HanifJauharIslami/EcoBin/Progress Report Per Minggu/Laporan Minggu Ke-11.pdf

# EcoBin

### Inovasi Tempat Sampah Pintar Berbasis IoT untuk Pemilahan Sampah Otomatis dan Ramah Lingkungan


Nama Anggota Team:

1. Regar Mukti Wijaya / 2122600032 | (Hardware Developer)
2. Yunanta Adi Wijaya / 2122600035 | (Data Analyst)
3. Veda Alfa Elydal / 2122600039 | (Software Developer)
4. Dwi Angga Ramadhani / 2122600053 | (UI/UX Designer)
5. Hanif Jauhar Islami / 2122600048 | (Project Manager)
6. Dewa Gede Angkasa Arinanta / 2122600059 | (3D Designer)

Progress Laporan Mingguan

Laporan Minggu Ke-11

- Pembuatan video demonstrasi rangkaian pada aplikasi Wokwi di Youtube

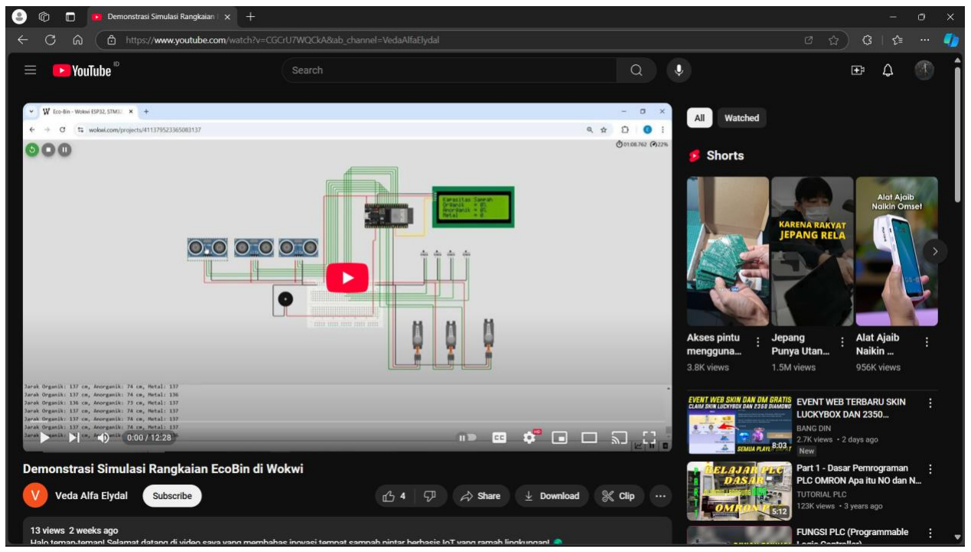
[picture p19: figure]

- Pembelian komponen untuk pembuatan hardware
List komponen yang diperlukan untuk pembuatan projek ini telah dilampirkan pada tampilan README.md dengan detail sebagai berikut:
1. Hardware
a. ESP32
b. Sensor Ultrasonik
c. Sensor Proximity Induktif
d. Sensor Proximity Kapasitif
e. Sensor Proximity Infrared
f. Motor Servo
g. LCD 20X4 I2C
h. Modul Df Player
i. Speaker
j. Power Supply
2. Software
a. Arduino ide
b. KiCad
c. Inventor
d. Visual Studio Code (VSC)
e. Eagle
3. Alat
a. Solder
b. Timah solder

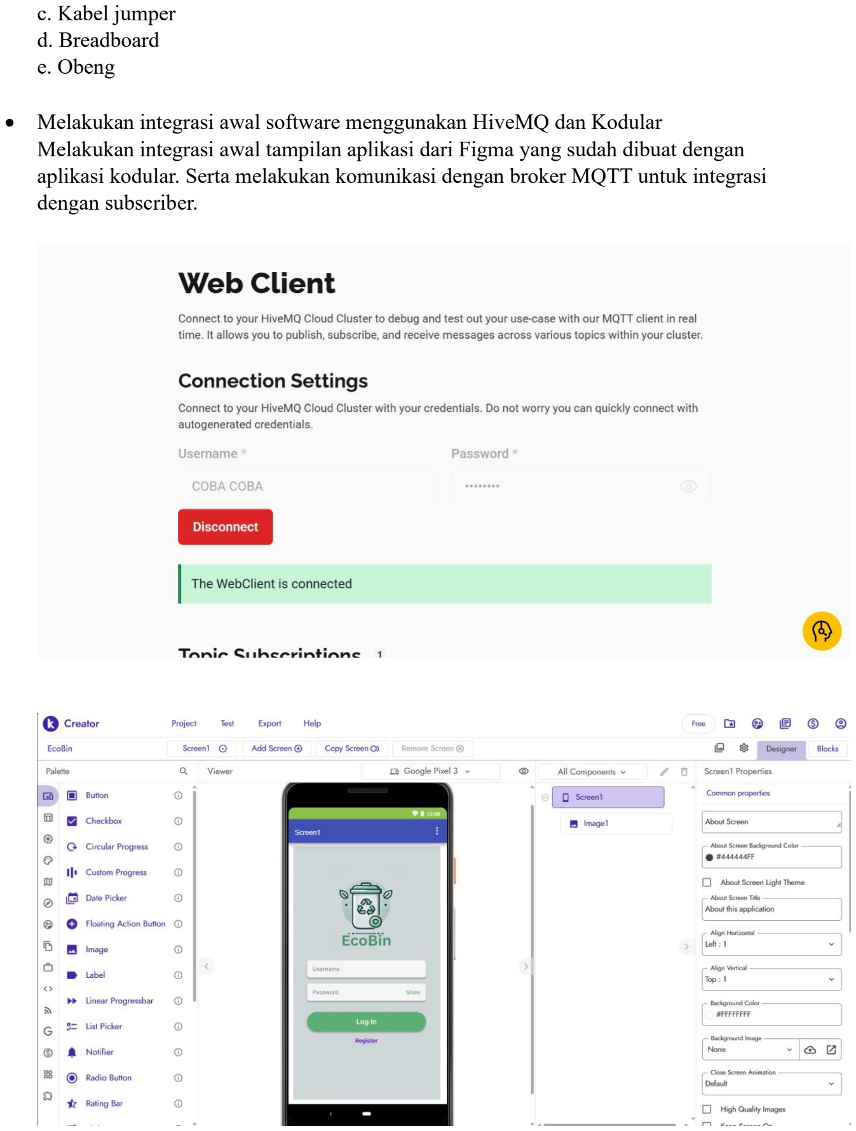
[picture p20: page 3]

c. Kabel jumper
d. Breadboard
e. Obeng
- Melakukan integrasi awal software menggunakan HiveMQ dan Kodular Melakukan integrasi awal tampilan aplikasi dari Figma yang sudah dibuat dengan aplikasi kodular. Serta melakukan komunikasi dengan broker MQTT untuk integrasi dengan subscriber.
