HanifJauharIslami/EcoBin/Progress Report Per Minggu/Laporan Minggu Ke-10.pdf

# EcoBin

### Inovasi Tempat Sampah Pintar Berbasis IoT untuk Pemilahan Sampah Otomatis dan Ramah Lingkungan


Nama Anggota Team:

1. Regar Mukti Wijaya / 2122600032 | (Hardware Developer)
2. Yunanta Adi Wijaya / 2122600035 | (Data Analyst)
3. Veda Alfa Elydal / 2122600039 | (Software Developer)
4. Dwi Angga Ramadhani / 2122600053 | (UI/UX Designer)
5. Hanif Jauhar Islami / 2122600048 | (Project Manager)
6. Dewa Gede Angkasa Arinanta / 2122600059 | (3D Designer)

Progress Laporan Mingguan

Laporan Minggu Ke-10

- Pembuatan Blok Diagram Sistem EcoBin

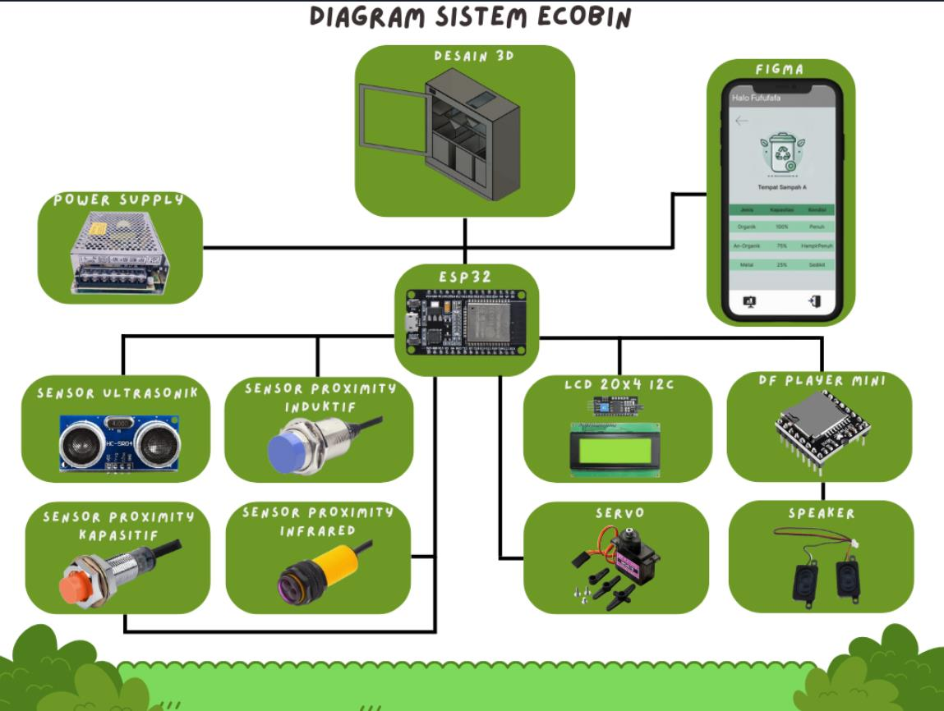
[picture p21: figure]

- Finishing Desain Skematik PCB EcoBin
Penyelesaian tahap desain skematik PCB menggunakan software KiCad, dan juga pencetakan PCB dengan detail desain skematik sebagai berikut:

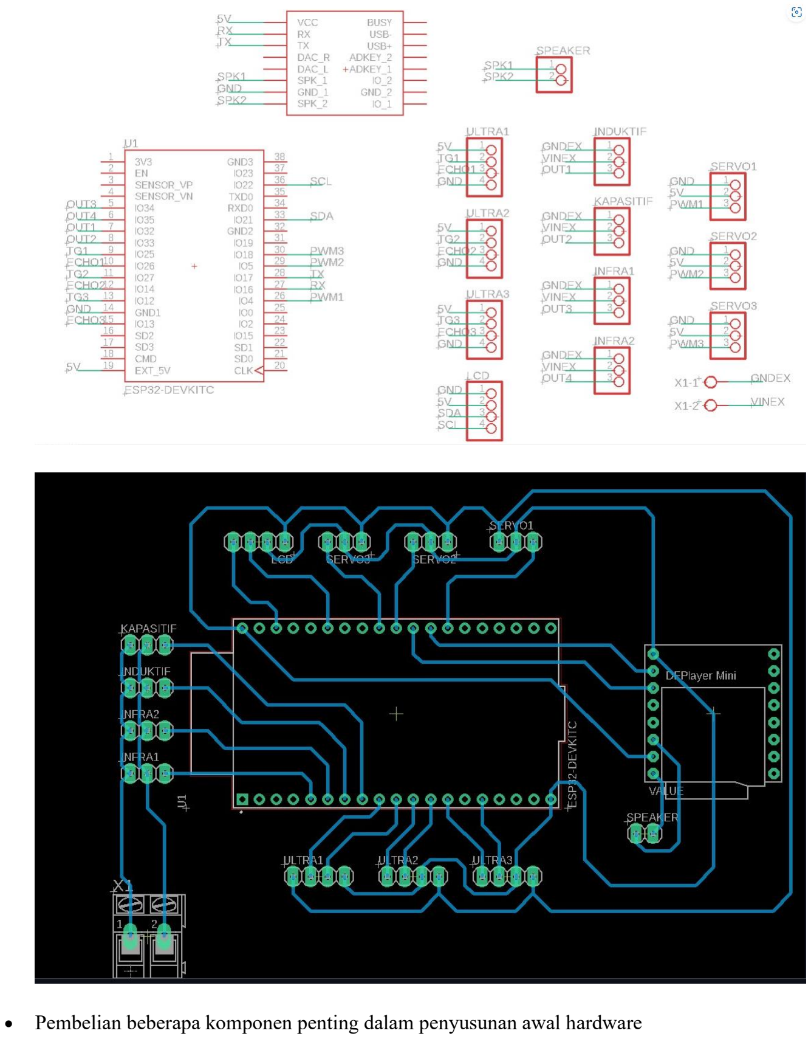
[picture p22: page 3]

- Pembelian beberapa komponen penting dalam penyusunan awal hardware

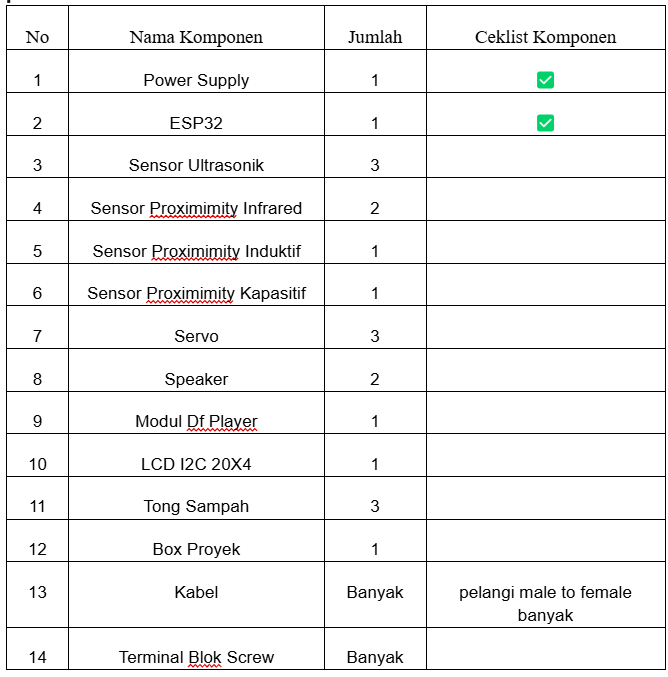
[picture p23: figure]
