HanifJauharIslami/EcoBin/Progress Report Per Minggu/Laporan Minggu Ke-14.pdf

# EcoBin

### Inovasi Tempat Sampah Pintar Berbasis IoT untuk Pemilahan Sampah Otomatis dan Ramah Lingkungan


Nama Anggota Team:

1. Regar Mukti Wijaya / 2122600032 | (Hardware Developer)
2. Yunanta Adi Wijaya / 2122600035 | (Data Analyst)
3. Veda Alfa Elydal / 2122600039 | (Software Developer)
4. Dwi Angga Ramadhani / 2122600053 | (UI/UX Designer)
5. Hanif Jauhar Islami / 2122600048 | (Project Manager)
6. Dewa Gede Angkasa Arinanta / 2122600059 | (3D Designer)

Progress Laporan Mingguan

Laporan Minggu Ke-14

- Finalisasi Alat
Setelah pengecekan dari semua komponen bekerja dengan normal, maka EcoBin dapat digunakan dengan hasil dari video simulasi, video promosi, animasi 3D, hingga video presentasi yang detailnya dapat dilihat pada github bagian Readme.

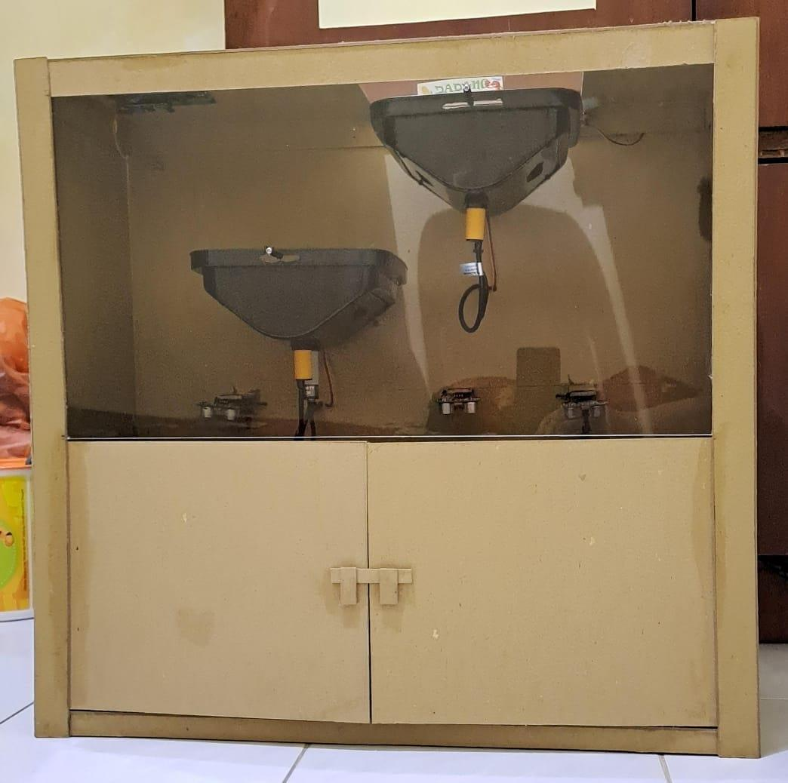
[picture p31: figure]

EcoBin yang sudah siap digunakan

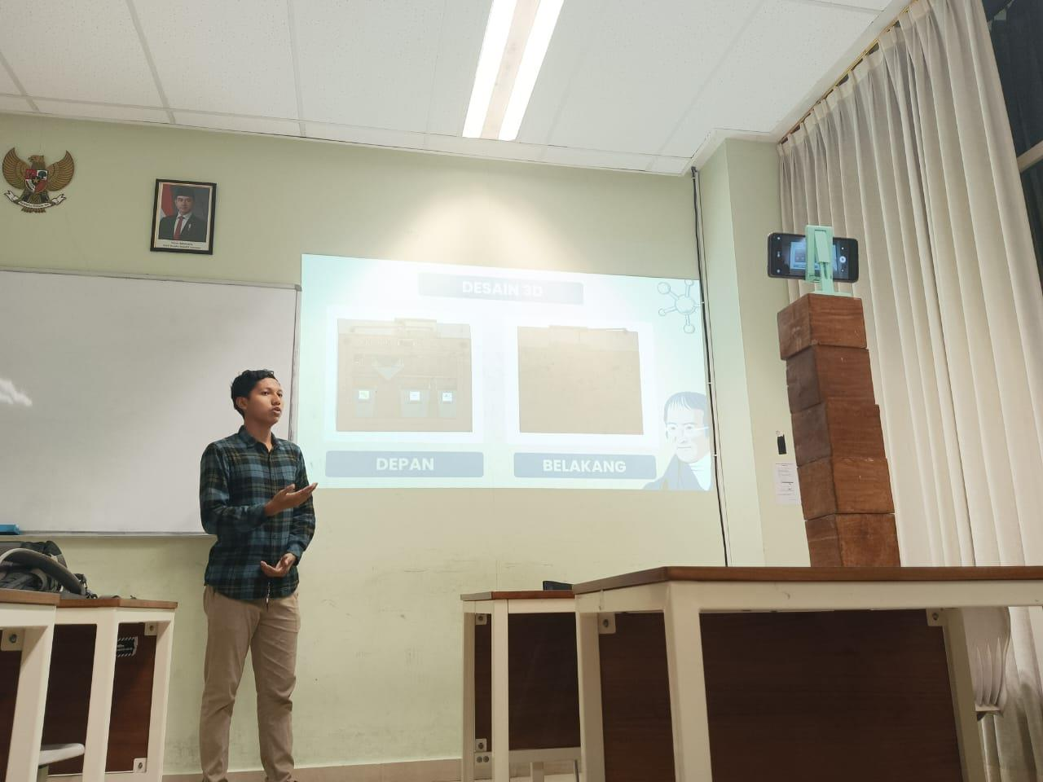
[picture p32: figure]

Presentasi Final Project EcoBin
