HanifJauharIslami/EcoBin/Dokumentasi/Flyer_EcoBin.pdf

# Inovasi Tempat Sampah Pintar Berbasis IoT untuk Pemilihan Sampah Otomatis dan Ramah Lingkungan

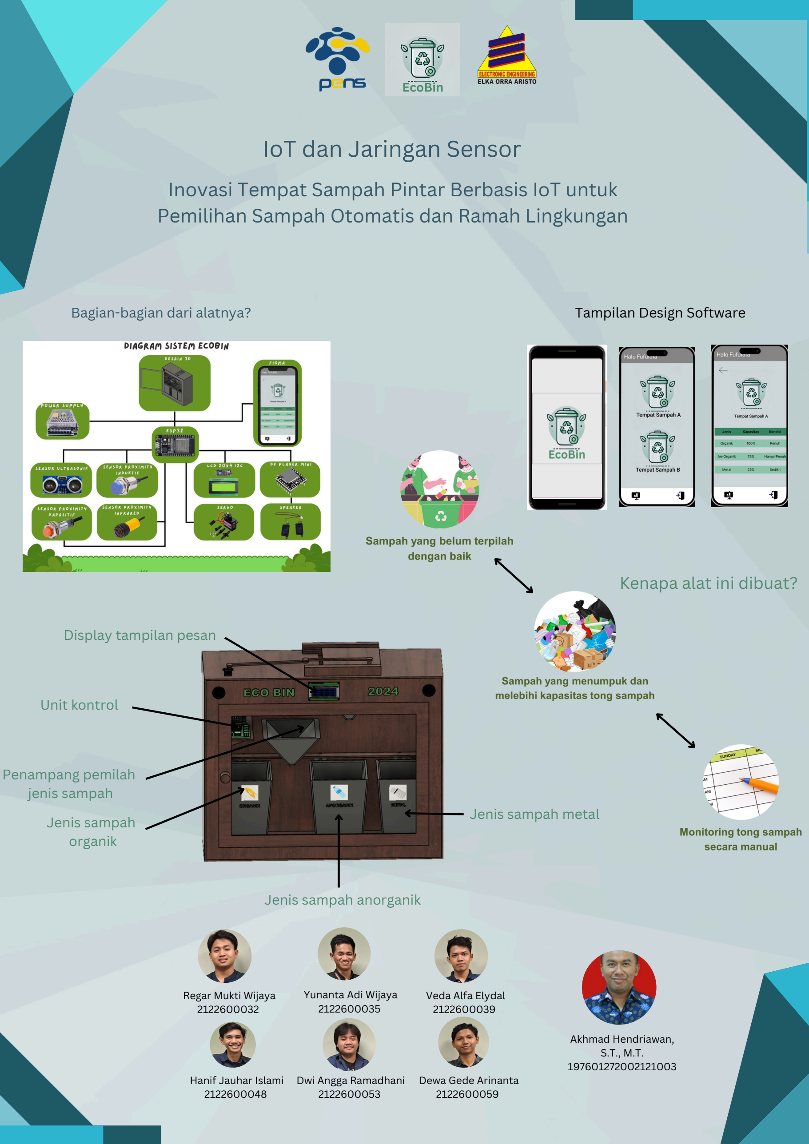
[picture p35: page 1]

## Display tampilan pesan

## Unit kontrol

## Penampang pemilah jenis sampah

## Jenis sampah organik

## Jenis sampah anorganik

## Jenis sampah metal

## Kenapa alat ini dibuat?

## Bagian-bagian dari alatnya?

Regar Mukti Wijaya
2122600032

Yunanta Adi Wijaya
2122600035

Veda Alfa Elydal
2122600039

Hanif Jauhar Islami
2122600048

Dwi Angga Ramadhani
2122600053

Dewa Gede Arinanta
2122600059

Akhmad Hendriawan,
S.T., M.T.
197601272002121003

## Tampilan Design Software

# IoT dan Jaringan Sensor
