HanifJauharIslami/EcoBin/Desain & Perencanaan/Mind Map Ide Project.pdf

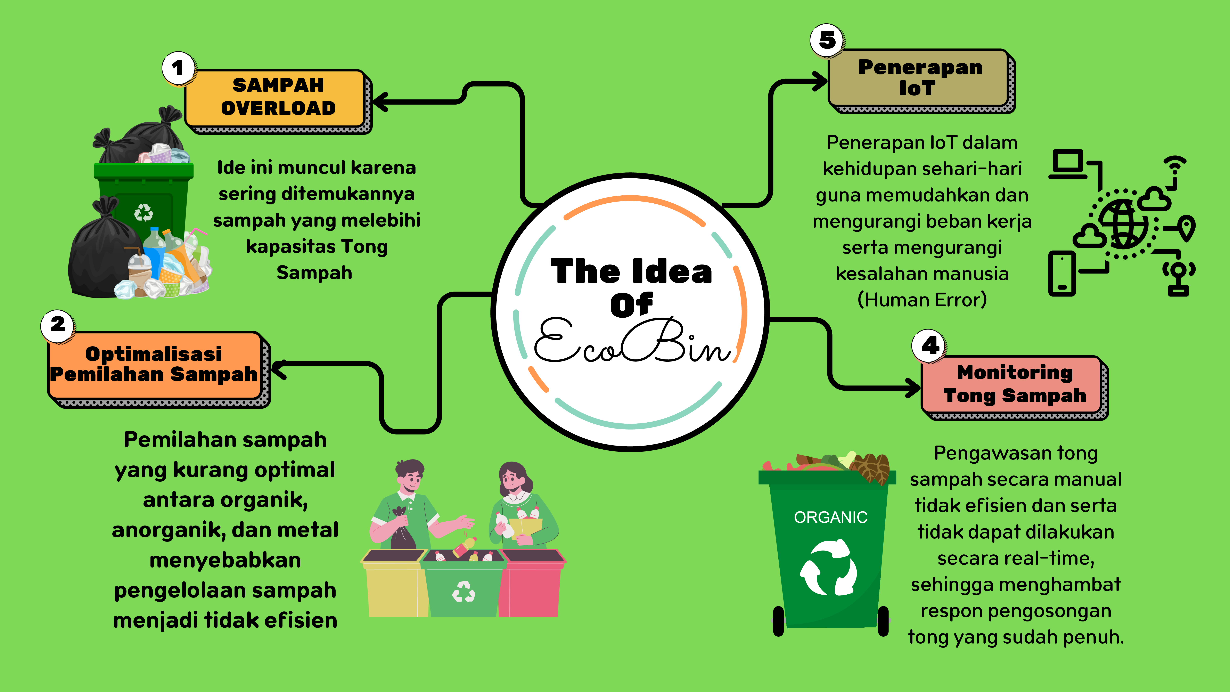
[picture p36: page 1]
