HanifJauharIslami/EcoBin/Desain 3D EcoBin/3D-Terbuka.png

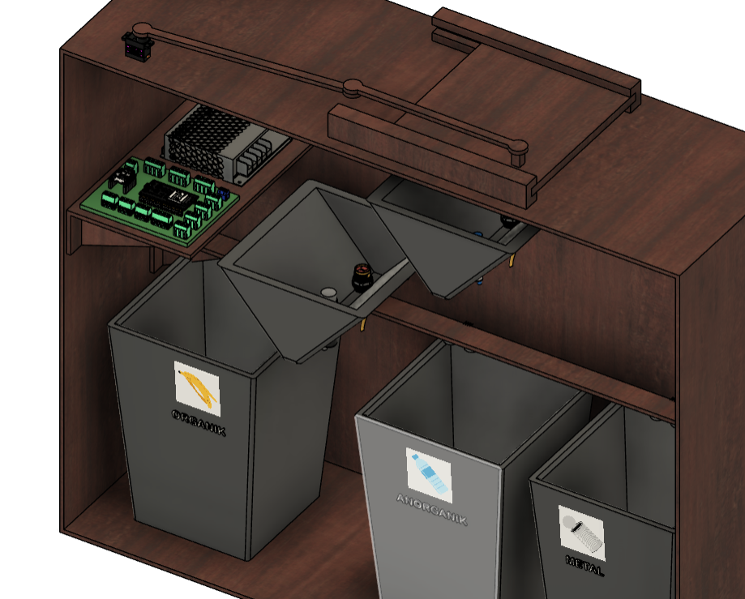
Desain 3D EcoBin/3D-Terbuka.png
