HanifJauharIslami/EcoBin/Desain 3D EcoBin/Desain 3D - Tampak Atas.png

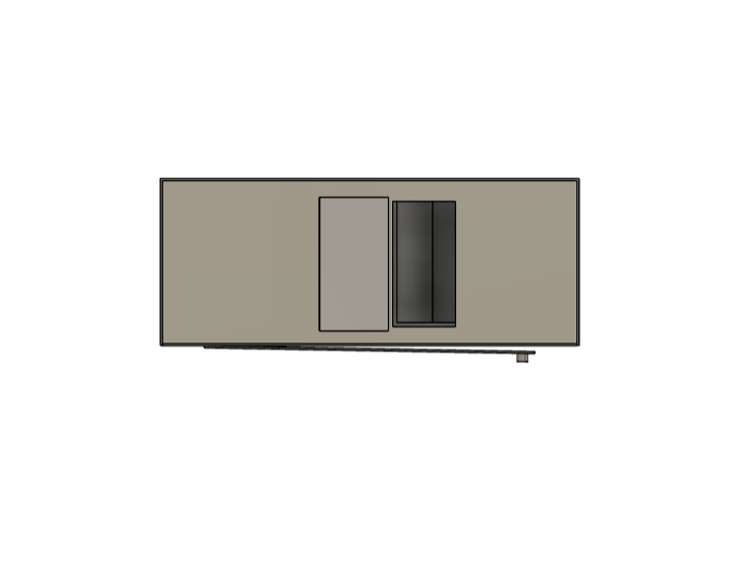
Desain 3D EcoBin/Desain 3D - Tampak Atas.png
