HanifJauharIslami/EcoBin/Desain 3D EcoBin/Desain 3D - Tampak Belakang.png

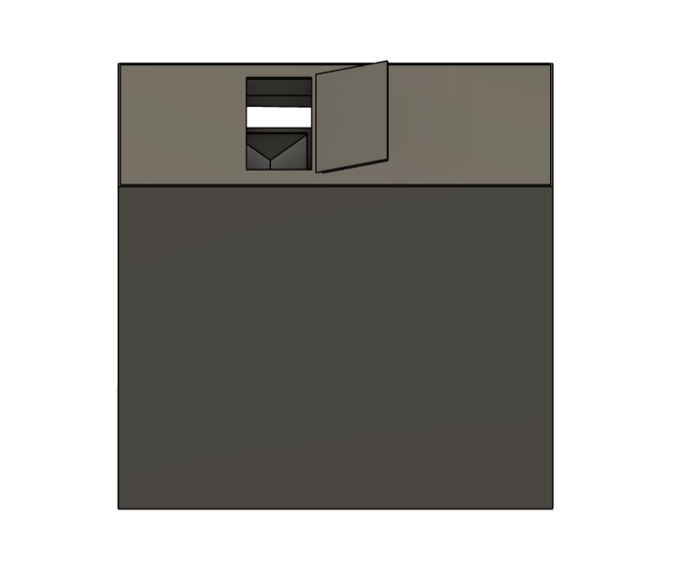
Desain 3D EcoBin/Desain 3D - Tampak Belakang.png
