HanifJauharIslami/EcoBin/Desain 3D EcoBin/Desain 3D - Tampak Depan.png

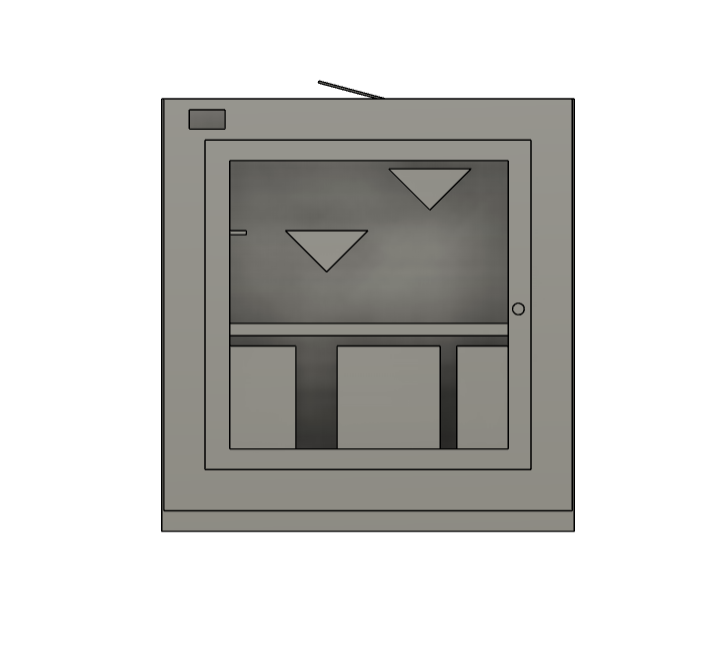
Desain 3D EcoBin/Desain 3D - Tampak Depan.png
