HanifJauharIslami/EcoBin/Desain 3D EcoBin/Desain 3D - Tampak Samping.png

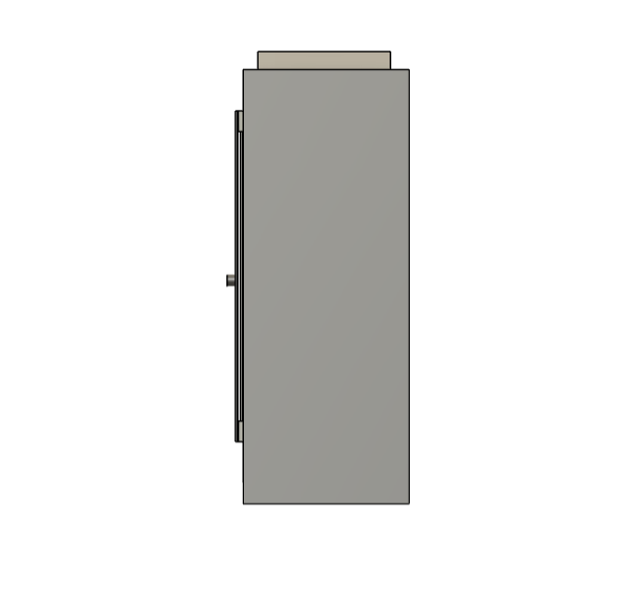
Desain 3D EcoBin/Desain 3D - Tampak Samping.png
