HanifJauharIslami/EcoBin/Desain 3D EcoBin/Desain 3D - Tampak Sudut.png

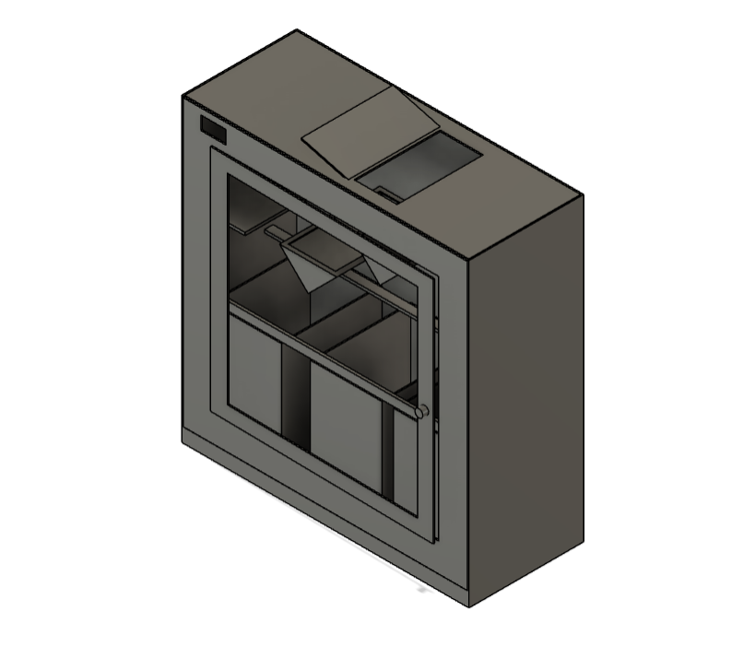
Desain 3D EcoBin/Desain 3D - Tampak Sudut.png
