HanifJauharIslami/EcoBin/Desain 3D EcoBin/Desain 3D Terbuka - Tampak Sudut.png

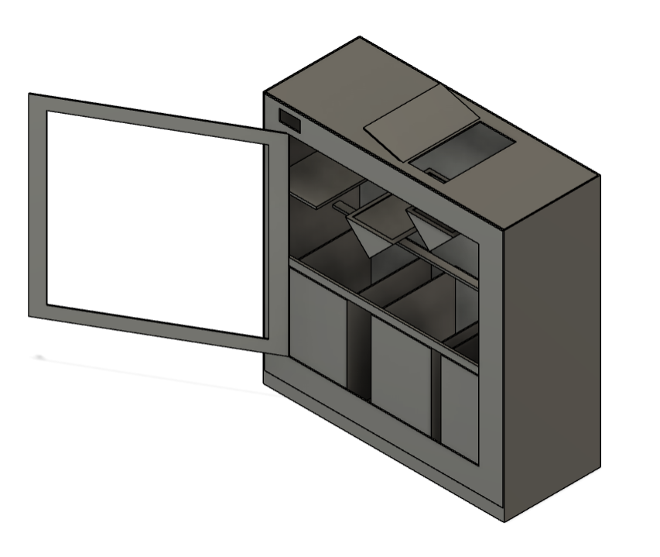
Desain 3D EcoBin/Desain 3D Terbuka - Tampak Sudut.png
