HanifJauharIslami/EcoBin/Dokumentasi/MQTTBox.jpg

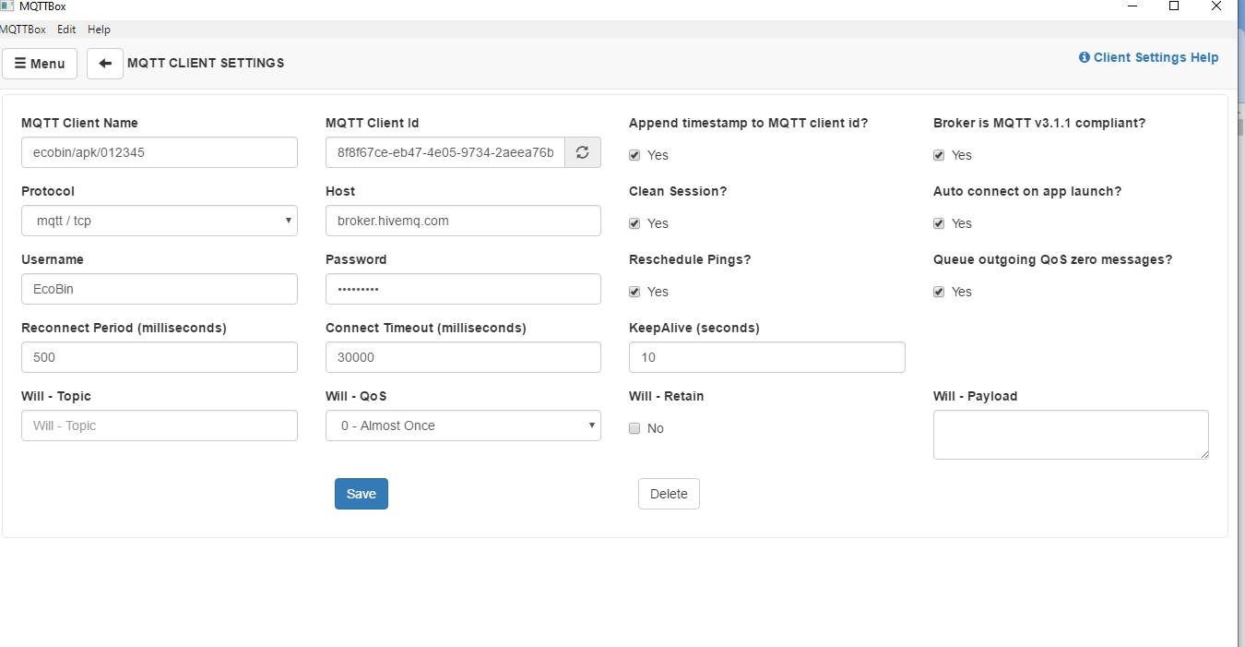
Dokumentasi/MQTTBox.jpg
