HanifJauharIslami/EcoBin/Dokumentasi/Topic MQTT (1).jpeg

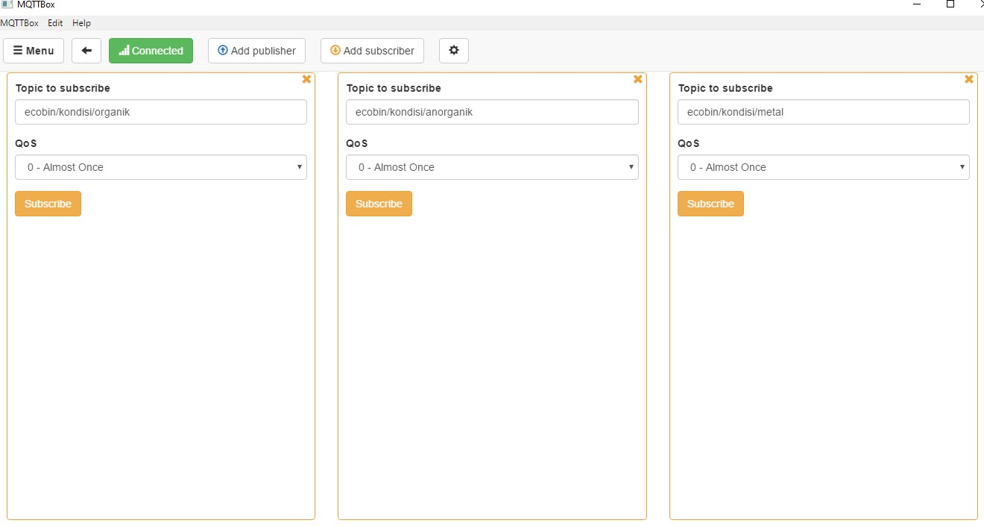
Dokumentasi/Topic MQTT (1).jpeg
