HanifJauharIslami/EcoBin/Dokumentasi/Topic MQTT.jpeg

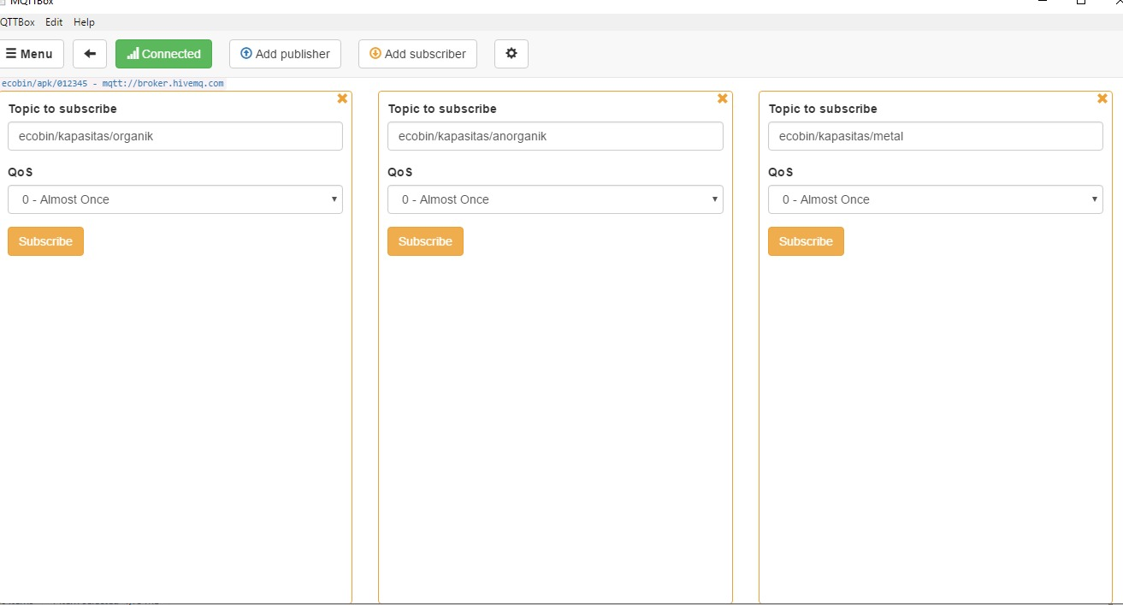
Dokumentasi/Topic MQTT.jpeg
