HanifJauharIslami/EcoBin/Pembuatan Aplikasi/Kodular/Media/google kodular.png

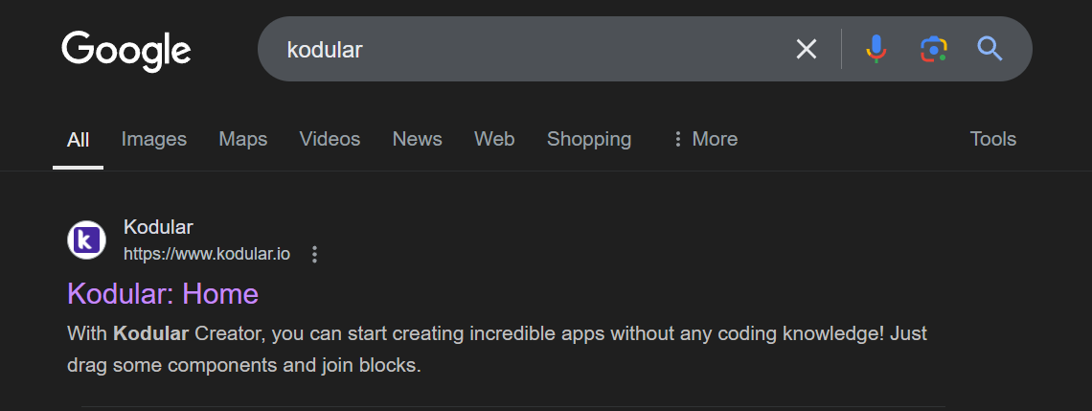
Pembuatan Aplikasi/Kodular/Media/google kodular.png
