HanifJauharIslami/EcoBin/Pembuatan Aplikasi/Kodular/Media/Login UI Kodular.png

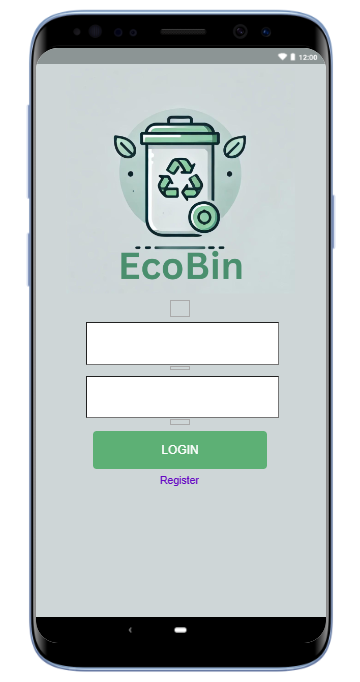
Pembuatan Aplikasi/Kodular/Media/Login UI Kodular.png
