HanifJauharIslami/EcoBin/Source Code ESP/WiFiManager.ino

#include <WiFiManager.h>

#define SetWifi 22

int timeout = 120;
bool sBlink;
unsigned long mBlink;

void setup() {
  Serial.begin(9600);
  pinMode(SetWifi, INPUT_PULLUP);
  pinMode(2, OUTPUT);
  digitalWrite(2, LOW);
  WiFi.mode(WIFI_STA);
  Serial.printf("\nStarting WiFi Manager\n");
}

void loop() {
  configurasiWIFI();

  if(millis() - mBlink >= 1000){
    mBlink = millis();
    sBlink= !sBlink;
    digitalWrite(2, sBlink);
  }
}

void configurasiWIFI(){
  if(digitalRead(SetWifi) == LOW){
    digitalWrite(2, HIGH);
    WiFiManager wm;
    wm.resetSettings();
    wm.setConfigPortalTimeout(timeout);
    if (!wm.startConfigPortal("EcoBin")) {
      Serial.println("failed to connect and hit timeout");
      delay(3000);
      ESP.restart();
    }
    Serial.printf("\nWiFi connected to : ");
    Serial.println(wm.getWiFiSSID(true));
  }
}
