HanifJauharIslami/EcoBin/(commit log)

2024-10-13 Add files via upload
    TimeLine pengerjaan Proyek EcoBin
    [TimeLine_EcoBin.xlsx]
2024-10-13 Create Source Code ESP32
2024-10-13 Create Code ESP32
